inethdidu-hub/MicroFlux_Project/(commit log)

2026-06-20 Add HTTP proxy relay for ESP32 tracker
2026-06-21 Fix proxy headers and add logging
    [esp32_tracker.ino]
2026-06-28 Update ESP32 firmware with local ADC battery reader and CSQ signal polling, and update Flutter app with GSM signal quality UI, WiFi Sign Out reset SMS configuration, and restored owner phone field
    [a9g_communication_test.ino, esp32_tracker.ino]
2026-07-02 Add project screenshots, circuit schematic, and PCB layouts to README.md and update pinout to GPIO 32
2026-07-02 Change alarm buzzer output to a continuous tone when active
    [esp32_tracker.ino]
2026-07-02 Disable PC serial debugging to eliminate UART0 bottlenecks and set Wi-Fi transmission interval to 80ms
